penma/fallblatt/(list of files, cad)

Other CAD files:
stl/libgear.scad
