penma/fallblatt/boards/master.brd

## EAGLE design boards/master.brd (2014-06-07)

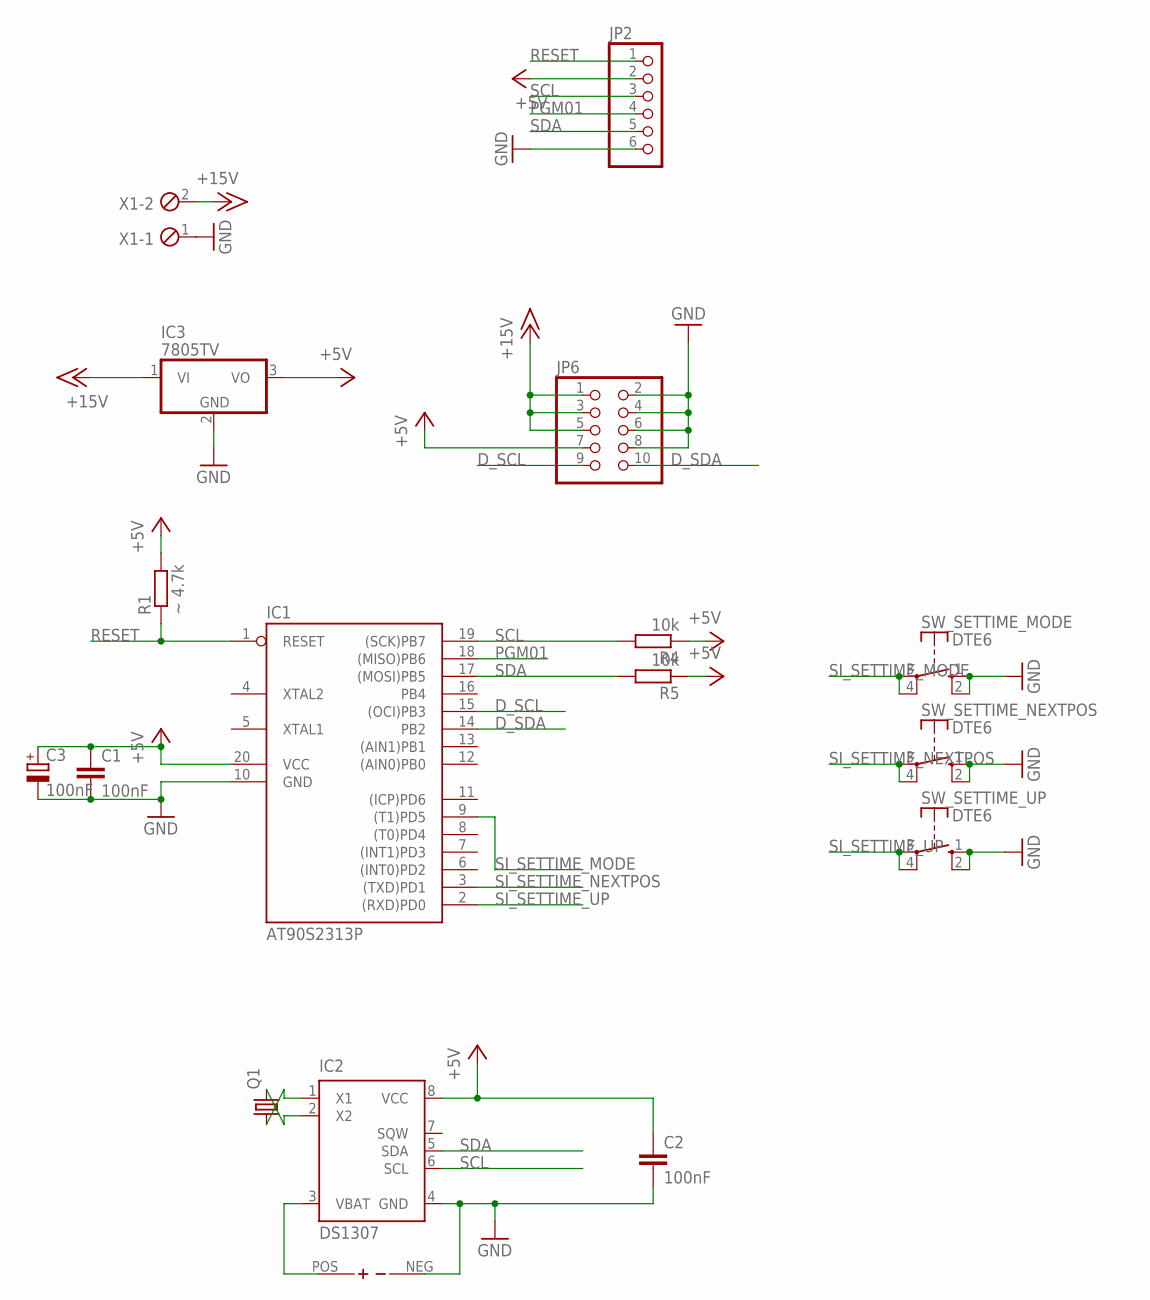
[picture p1: schematic master.sch]

Parts:
C1, C2: 100nF; C0805
C3: 100nF; E2,5-7
IC1: AT90S2313P; DIL20
IC2: DS1307; DIP-8
IC3: 7805TV; TO220V
JP2: PINHD-1X6; 1X06
JP6: PINHD-2X5; 2X05
Q1: CRYSTALQ-SMD-1MM; Q-SMD-1MM
R1: ~ 4.7k; 0207/10
R4, R5: 10k; 0207/10
SW_SETTIME_MODE: DTE6
SW_SETTIME_NEXTPOS: DTE6
SW_SETTIME_UP: DTE6
U$1: BATT
X1: MPT2; 2POL254

Connections:
+5V: C1.1, C2.1, C3.+, IC1.20 (VCC), IC2.8 (VCC), IC3.3 (VO), JP2.2, JP6.7, R1.2, R4.1, R5.1
+15V: IC3.1 (VI), JP6.1, JP6.3, JP6.5, X1.2
D_SCL: IC1.15 ((OCI)PB3), JP6.9
D_SDA: IC1.14 (PB2), JP6.10
GND: C1.2, C2.2, C3.-, IC1.10 (GND), IC2.4 (GND), IC3.2 (GND), JP2.6, JP6.2, JP6.4, JP6.6, JP6.8, SW_SETTIME_MODE.1 (S), SW_SETTIME_MODE.2 (S), SW_SETTIME_NEXTPOS.1 (S), SW_SETTIME_NEXTPOS.2 (S), SW_SETTIME_UP.1 (S), SW_SETTIME_UP.2 (S), U$1.NEG (V-), X1.1
unnamed: IC2.1 (X1), Q1.1
unnamed: IC2.2 (X2), Q1.2
PGM01: IC1.18 ((MISO)PB6), JP2.4
RESET: IC1.1 (RESET), JP2.1, R1.1
SCL: IC1.19 ((SCK)PB7), IC2.6 (SCL), JP2.3, R4.2
SDA: IC1.17 ((MOSI)PB5), IC2.5 (SDA), JP2.5, R5.2
SI_SETTIME_MODE: IC1.9 ((T1)PD5), SW_SETTIME_MODE.3, SW_SETTIME_MODE.4
SI_SETTIME_NEXTPOS: IC1.3 ((TXD)PD1), SW_SETTIME_NEXTPOS.3, SW_SETTIME_NEXTPOS.4
SI_SETTIME_UP: IC1.2 ((RXD)PD0), SW_SETTIME_UP.3, SW_SETTIME_UP.4
VBAT: IC2.3 (VBAT), U$1.POS (V+)

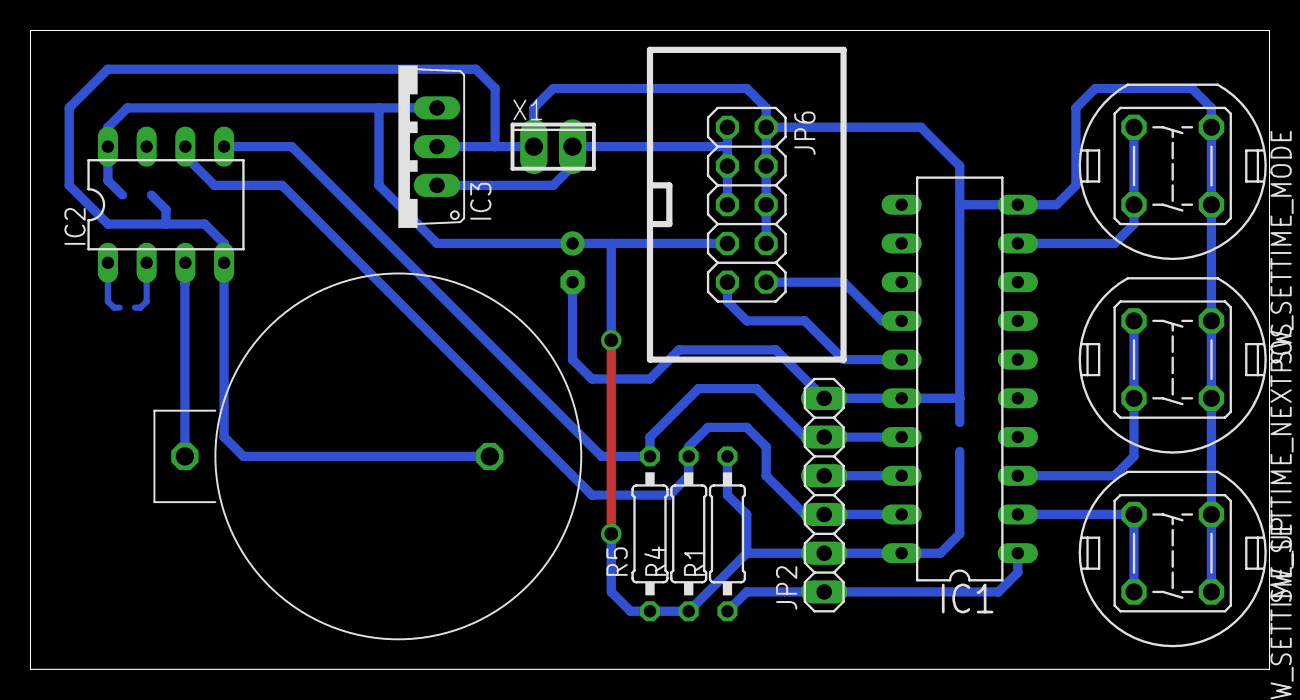
[picture p2: board master.brd from above]

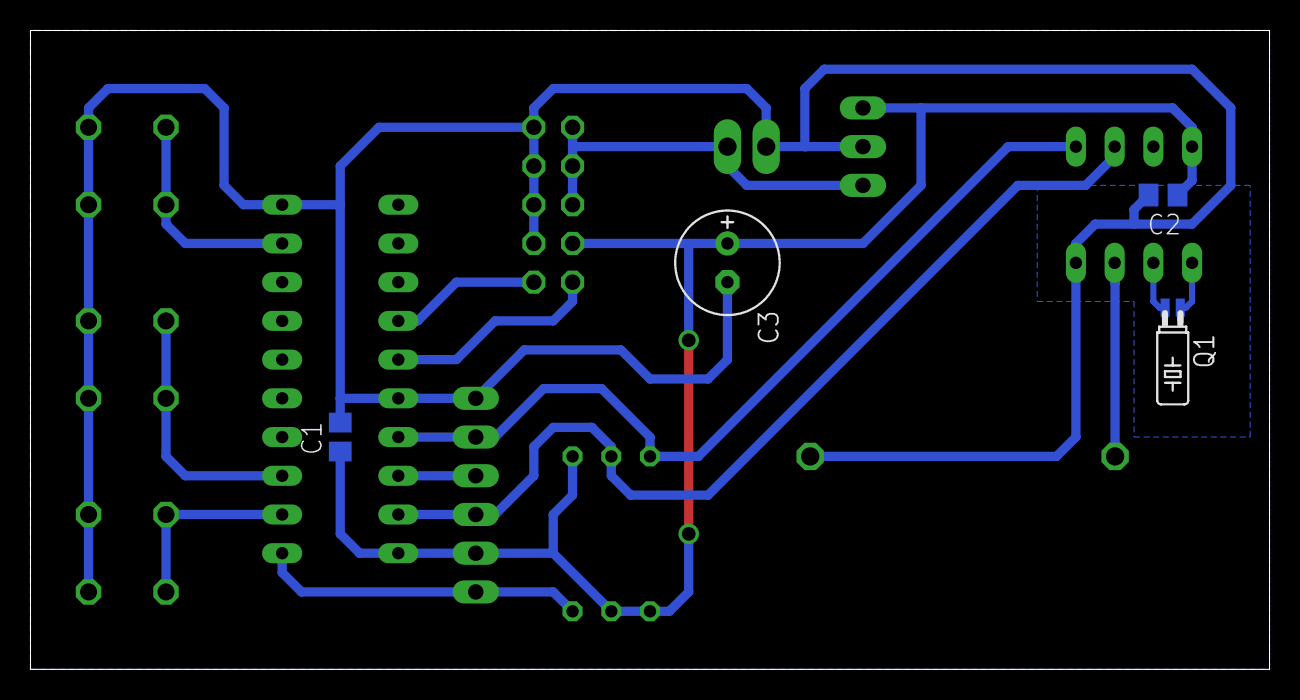
[picture p3: board master.brd from below]

Board: 2 copper layers, 81.3 x 41.9 mm, 17 parts (4 on the bottom side), 15 nets.
