penma/fallblatt/boards/slave.brd

## EAGLE design boards/slave.brd (2014-06-07)

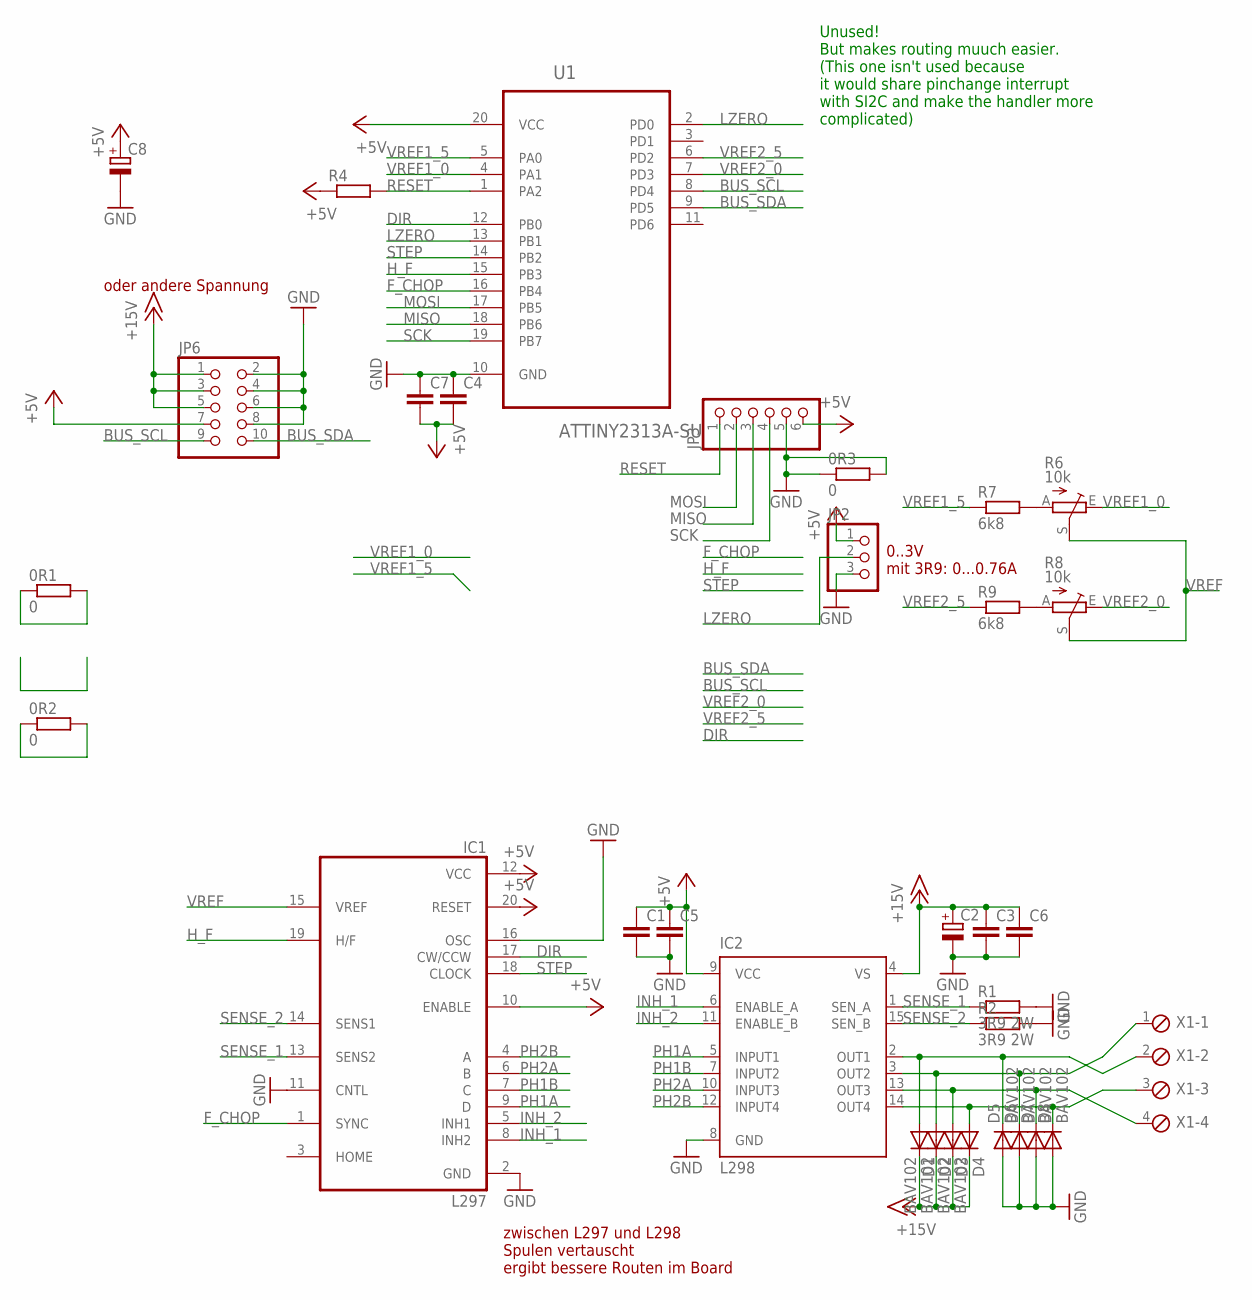
[picture p4: schematic slave.sch]

Parts:
0R1, 0R2, 0R3: 0; R1206
C1, C3, C4, C5, C6, C7: C-EUC0805; C0805
C2, C8: CPOL-EUE2.5-7; E2,5-7
D1, D2, D3, D4, D5, D6, D7, D8: BAV102; MINIMELF
IC1: L297; DIL20
IC2: L298; MULTIWATT-15
JP2: PINHD-1X3; 1X03
JP3: PINHD-1X6; 1X06
JP6: PINHD-2X5; 2X05
R1, R2: 3R9 2W; 0414/15
R4: R-EU_R1206; R1206
R6, R8: 10k; PT-10
R7, R9: 6k8; R1206
U1: ATTINY2313A-SU; SOIC127P1032X265-20N
X1: MPT4; 4POL254

Connections:
+5V: 0R1.1, 0R1.2, C1.1, C4.2, C5.1, C7.2, C8.+, IC1.10 (ENABLE), IC1.12 (VCC), IC1.20 (RESET), IC2.9 (VCC), JP2.1, JP3.6, JP6.7, R4.1, U1.20 (VCC)
+15V: C2.+, C3.1, C6.1, D1.C, D2.C, D3.C, D4.C, IC2.4 (VS), JP6.1, JP6.3, JP6.5
BUS_SCL: JP6.9, U1.8 (PD4)
BUS_SDA: JP6.10, U1.9 (PD5)
DIR: IC1.17 (CW/CCW), U1.12 (PB0)
F_CHOP: IC1.1 (SYNC), U1.16 (PB4)
GND: 0R3.1, 0R3.2, C1.2, C2.-, C3.2, C4.1, C5.2, C6.2, C7.1, C8.-, D5.A, D6.A, D7.A, D8.A, IC1.2 (GND), IC1.11 (CNTL), IC1.16 (OSC), IC2.8 (GND), JP2.3, JP3.5, JP6.2, JP6.4, JP6.6, JP6.8, R1.2, R2.2, U1.10 (GND)
H_F: IC1.19 (H/F), U1.15 (PB3)
INH_1: IC1.8 (INH2), IC2.6 (ENABLE_A)
INH_2: IC1.5 (INH1), IC2.11 (ENABLE_B)
LZERO: JP2.2, U1.2 (PD0), U1.13 (PB1)
MISO: JP3.3, U1.18 (PB6)
MOSI: JP3.2, U1.17 (PB5)
unnamed: R6.A, R7.2
unnamed: R8.A, R9.2
unnamed: D1.A, D5.C, IC2.2 (OUT1), X1.2
unnamed: D2.A, D6.C, IC2.3 (OUT2), X1.1
unnamed: D3.A, D7.C, IC2.13 (OUT3), X1.4
unnamed: D4.A, D8.C, IC2.14 (OUT4), X1.3
PH1A: IC1.9 (D), IC2.5 (INPUT1)
PH1B: IC1.7 (C), IC2.7 (INPUT2)
PH2A: IC1.6 (B), IC2.10 (INPUT3)
PH2B: IC1.4 (A), IC2.12 (INPUT4)
RESET: JP3.1, R4.2, U1.1 (PA2)
SCK: JP3.4, U1.19 (PB7)
SENSE_1: IC1.13 (SENS2), IC2.1 (SEN_A), R1.1
SENSE_2: IC1.14 (SENS1), IC2.15 (SEN_B), R2.1
STEP: IC1.18 (CLOCK), U1.14 (PB2)
VREF: 0R2.1, 0R2.2, IC1.15 (VREF), R6.S, R8.S
VREF1_0: R6.E, U1.4 (PA1)
VREF1_5: R7.1, U1.5 (PA0)
VREF2_0: R8.E, U1.7 (PD3)
VREF2_5: R9.1, U1.6 (PD2)

Notes on the sheet:
0..3V mit 3R9: 0...0.76A
oder andere Spannung
zwischen L297 und L298 Spulen vertauscht ergibt bessere Routen im Board
Unused! But makes routing muuch easier. (This one isn't used because it would share pinchange interrupt with SI2C and make the handler more complicated)

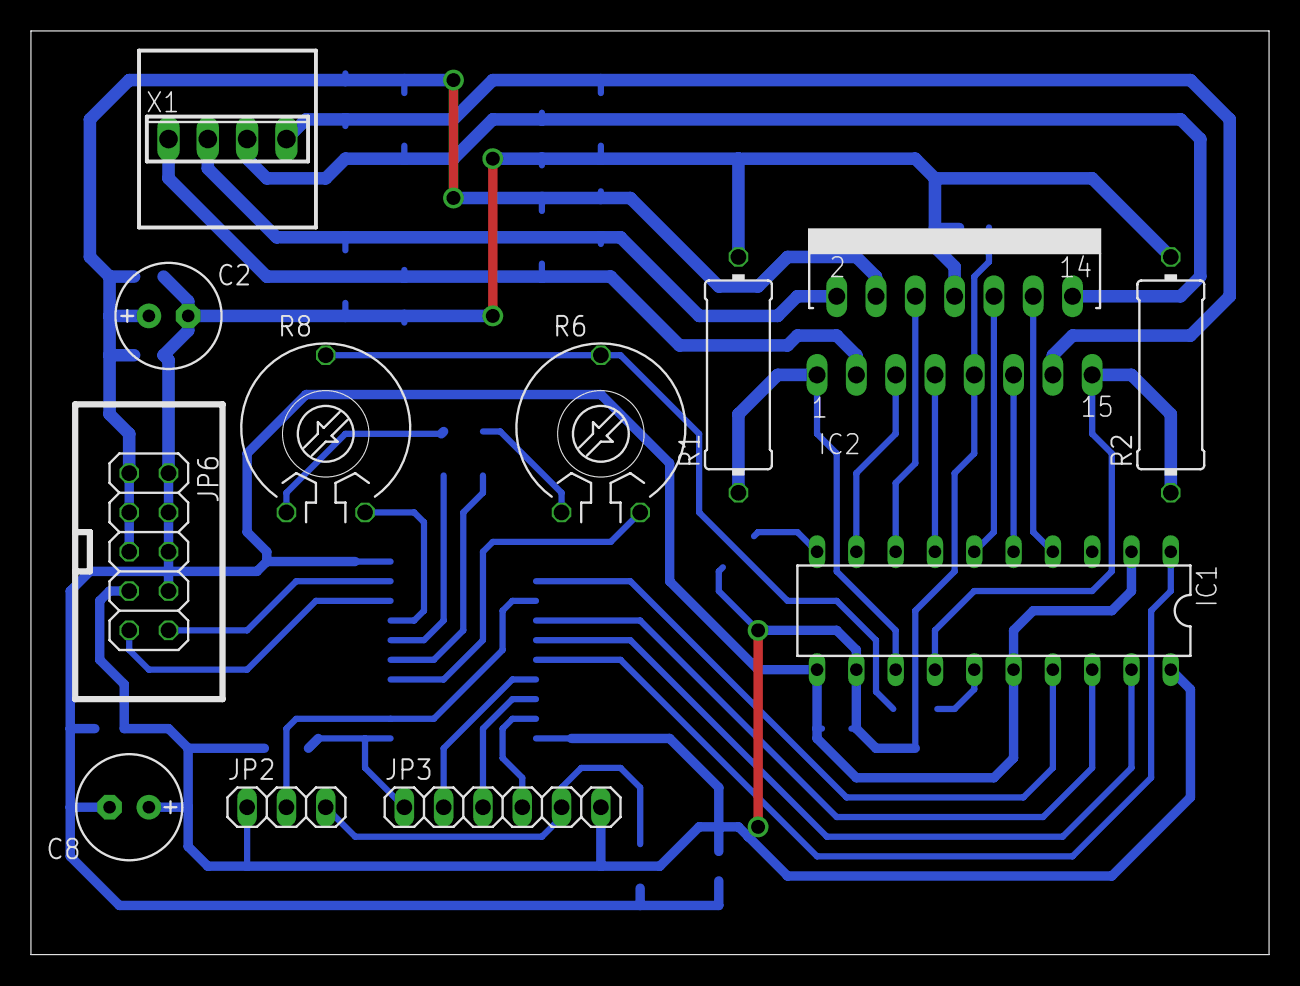
[picture p5: board slave.brd from above]

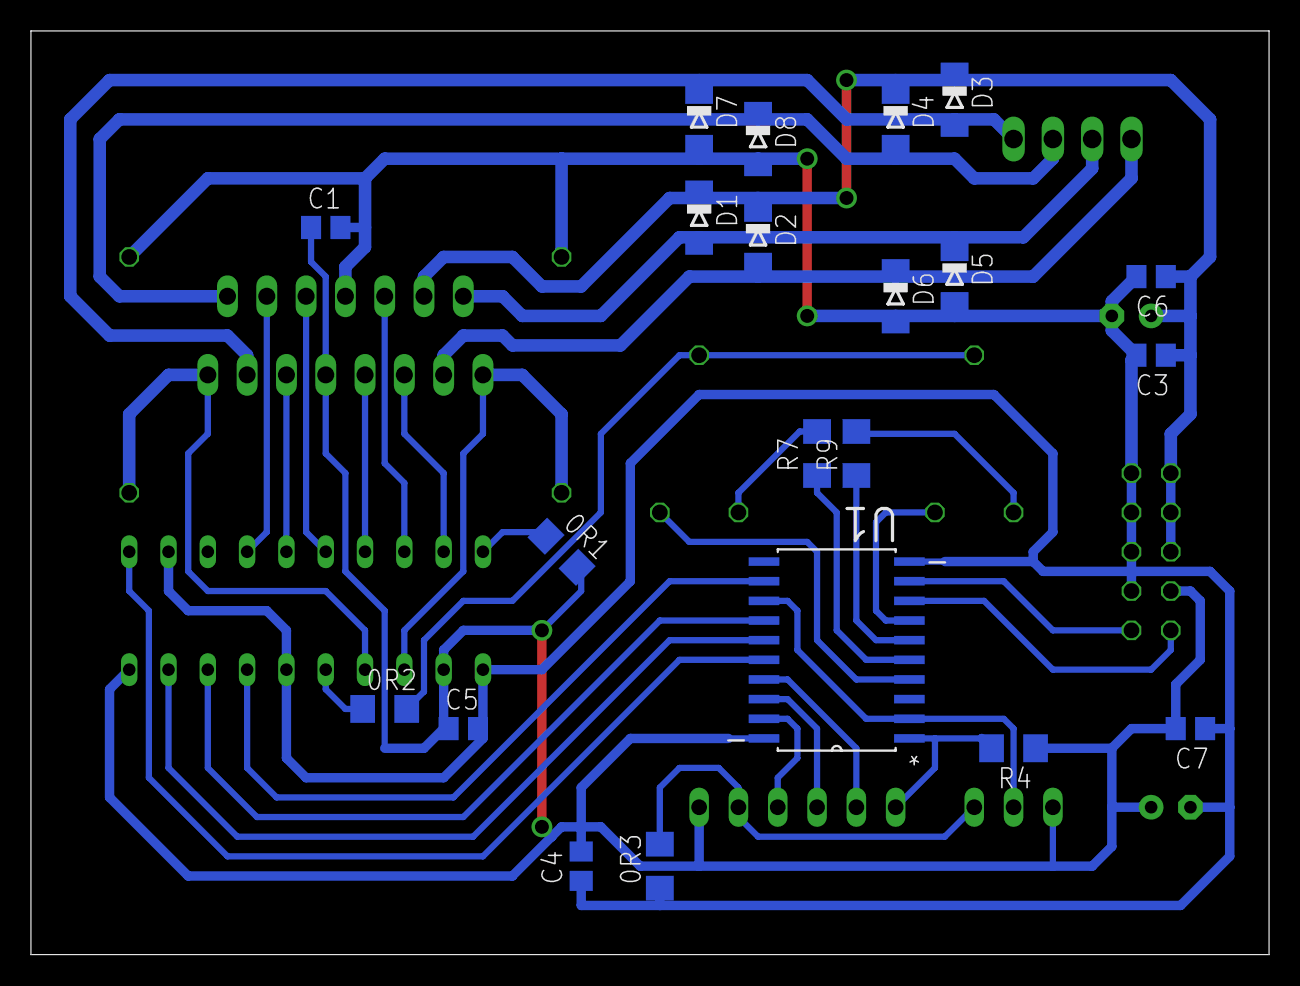
[picture p6: board slave.brd from below]

Board: 2 copper layers, 80.0 x 59.7 mm, 33 parts (21 on the bottom side), 33 nets.
