penma/fallblatt/(commit log)

2013-11-29 Schnecke vorgerendert (spart Zeit!)
    [Schnecke_bare.stl]
2013-11-30 Aufnahme für Motor + Kugellager
    [Schnecke.scad, _templ_MotorAufnahme.scad]
2013-12-01 Motoraufnahme optimiert
    [MotorAufnahme.scad, _templ_MotorAufnahme.scad]
2013-12-03 Motor Gegenstück 1mm flacher, kollidiert dann nicht mehr mit Schnecke
    [MotorAufnahme.scad]
2013-12-04 Motoraufnahme: gefixt und in mehr Funktionen zerteilt
    [MotorAufnahme.scad]
2013-12-04 Motoraufnahme: Schnecke nicht aus stl
    [MotorAufnahme.scad]
2013-12-04 Mittelstift und Blaetterrad Demos umstrukturiert
    [Blaetterrad.scad, Mittelstift.scad, Schnecke.scad]
2013-12-04 Mittelstift: muss nicht 100% hohl sein
    [Mittelstift.scad]
2013-12-05 Mittelstift: Druckeinstellungen dazu
    [Mittelstift.scad]
2013-12-05 RahmenVerbinder: neuer Verbinder für die Seitenteile
    (vormals mit Seitenteil verbunden)
    [RahmenVerbinder.scad]
2013-12-06 seitenteil etwas geupdated
    [seitenteil2.scad]
2013-12-06 neues seitenteil
    [RahmenVerbinder.scad, seitenteil2.scad]
2013-12-06 Schnecke verlängert
    [Schnecke.scad, Schnecke_bare.stl]
2013-12-07 Seitenteil neu gebaut
    [Mittelstift.scad, MotorAufnahme.scad, RahmenVerbinder.scad, Schnecke.scad, seitenteil2.scad]
2013-12-08 Seitenteil: Wandstärke runter
    [seitenteil2.scad]
2013-12-08 Rahmenverbinder: mehr Parameter.
    (bisschen was fehlt noch)
    [RahmenVerbinder.scad]
2013-12-08 Rahmen: Nupsis weg und Löcher für durchgehende Achse rein
    Rahmen neigt dazu sich genau am Rad nach außen zu biegen. Mit Nupsis ist das
    ein Problem, auch wenn es mit langen Nupsis noch funktioniert. Suboptimal
    ist das trotzdem
    Lösung: Achse durchgehend und beidseitig verkleben.
    [seitenteil2.scad]
2013-12-08 Mittelstift wieder durchgehend hohl
    [Mittelstift.scad]
2013-12-12 Innenabstand verbreitert, mehr Zahnräder
    [Blaetterrad.scad, Mittelstift.scad, RahmenVerbinder.scad, seitenteil2.scad]
2013-12-14 Lasercut template (25x50 cm)
2013-12-14 Radlager verkleinert
    Da wird eh nie ein Kugellager eingebaut und damit verbraucht es nur unnötig
    Platz im Rahmen. -> Kleiner machen
    [RadLager.scad, seitenteil2.scad]
2013-12-14 Mehr Zahnräder!
    [Schnecke.scad, seitenteil2.scad]
2013-12-14 Schnecke+Rad modifiziert, Seitenteil angepasst
    [MotorAufnahme.scad, Schnecke.scad, Schnecke_mini_bare.stl, seitenteil2.scad]
2013-12-15 Schnecke: neu gedruckt -> Daten.
    [Schnecke.scad]
2013-12-16 Blätterrad: Löcher verkleinert, Zahnrad verkleinert, durchgehendes Loch
    [Blaetterrad.scad]
2013-12-18 seitenteil updated
    [seitenteil2.scad]
2014-01-02 random änderungen der letzten tage
    [Blaetterrad.scad, LichtschrankeMount.scad, LichtschrankeRad.scad, Mittelstift.scad, RadLager.scad, RahmenVerbinder.scad, ServoMount.scad, ServoRad.scad]
2014-01-04 various fixes
    Lichtschranke Montage optimiert
    Lichtschranke Rad enger gemacht (weniger Wackeln)
    Seitenteil Achse nach hinten verschoben (sonst durchrutschen)
    [LichtschrankeMount.scad, LichtschrankeRad.scad, ServoMount.scad, seitenteil2.scad]
2014-01-06 Achse 5mm -> 4mm
    [LichtschrankeRad.scad, Mittelstift.scad, seitenteil2.scad]
2014-01-07 aufräumen
    [MotorAufnahme.scad, MotorRitzel.scad, Schnecke.scad, Schnecke_bare.stl, Schnecke_mini_bare.stl]
2014-01-07 bisschen weniger mischmasch
    [LichtschrankeHalterung.scad, ServoHalterung.scad, seitenteil2.scad]
2014-01-07 Seitenteil: etwas mehr Lesbarkeit
    [seitenteil2.scad]
2014-01-07 mehr aufräumen
    [libthread.scad]
2014-03-11 anscheinend letzte Version von v1
    [Blaetterrad.scad, LichtschrankeRad.scad, Plaettchen.scad, RadLager.scad, ServoRad.scad, seitenteil2.scad]
2014-03-16 lol, steppermount
    [steppermount.scad]
2014-06-07 seitenteil etwas entmüllen
    [LichtschrankeHalterung.scad, LichtschrankeRad.scad, seitenteil2.scad]
2014-06-07 Seitenwand mehr entmüllt
    [RahmenVerbinder.scad, seitenteil2.scad]
2014-06-07 mehr weniger Müll
    [seitenteil2.scad]
2014-06-07 mehr ausmisten
    [RadLager.scad, ServoHalterung.scad, ServoRad.scad, seitenteil2.scad]
2014-06-07 Motordummy ist nicht Teil des Objekts
    [steppermount.scad]
2014-06-07 Mehr Eaglefiles!
    [master.brd, master.sch, slave.brd, slave.sch]
2014-06-07 ...und verschoben
    [master.brd, master.sch, slave.brd, slave.sch]
